Shhatrat/openNAS-case-for-ATX-instruction/stl/hdd-rail.stl

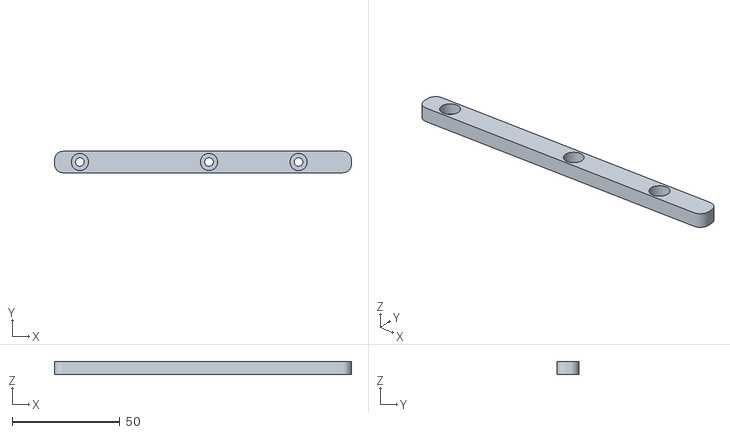
[picture p21: CAD file, 2026-10-17]
stl/hdd-rail.stl
138.0 x 10.0 x 6.00
