Shhatrat/openNAS-case-for-ATX-instruction/stl/foot-left.stl

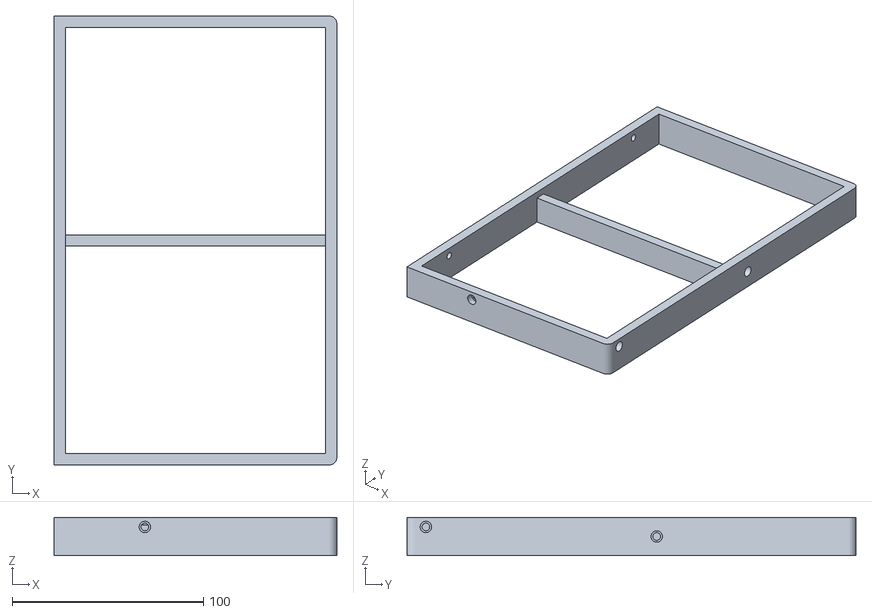
[picture p22: CAD file, 2026-10-17]
stl/foot-left.stl
148.0 x 235.0 x 20.0
