Shhatrat/openNAS-case-for-ATX-instruction/stl/rear-brace-long.stl

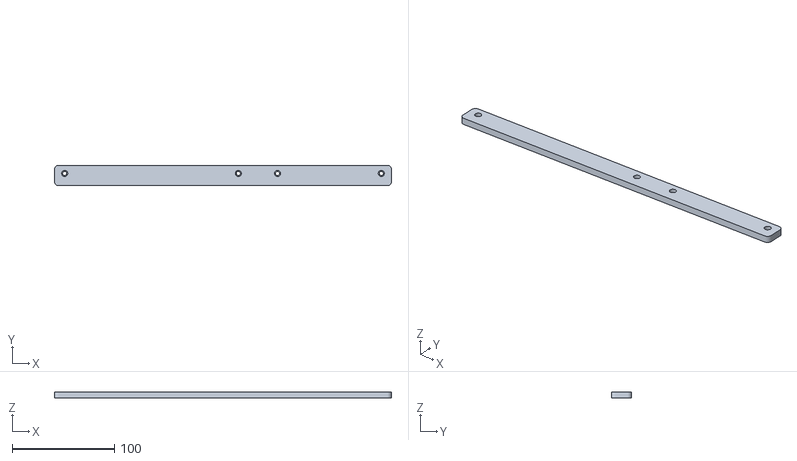
[picture p23: CAD file, 2026-10-17]
stl/rear-brace-long.stl
330.0 x 20.0 x 6.00
