Shhatrat/openNAS-case-for-ATX-instruction/stl/hdd-rack.stl

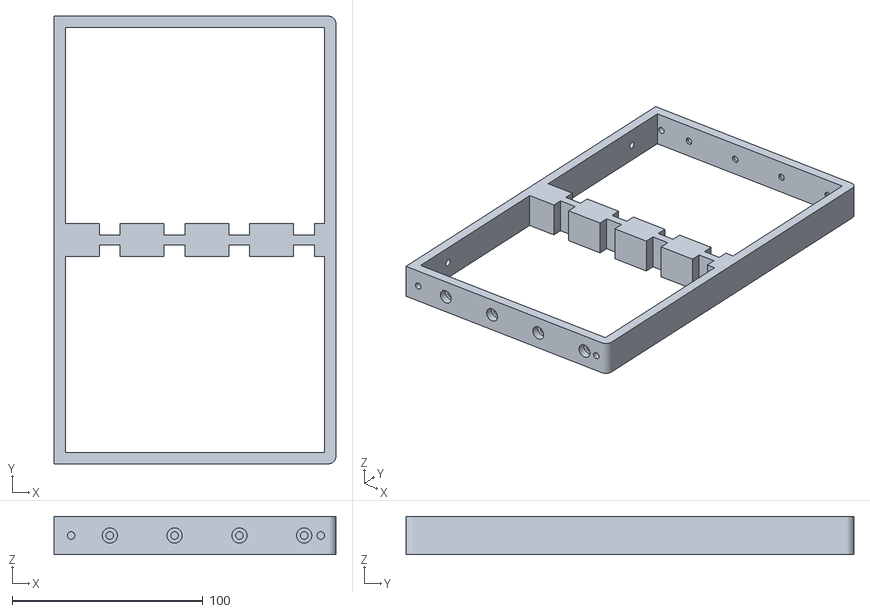
[picture p24: CAD file, 2026-10-17]
stl/hdd-rack.stl
148.0 x 235.0 x 20.0
