Shhatrat/openNAS-case-for-ATX-instruction/stl/front-brace-with-fanmount.stl

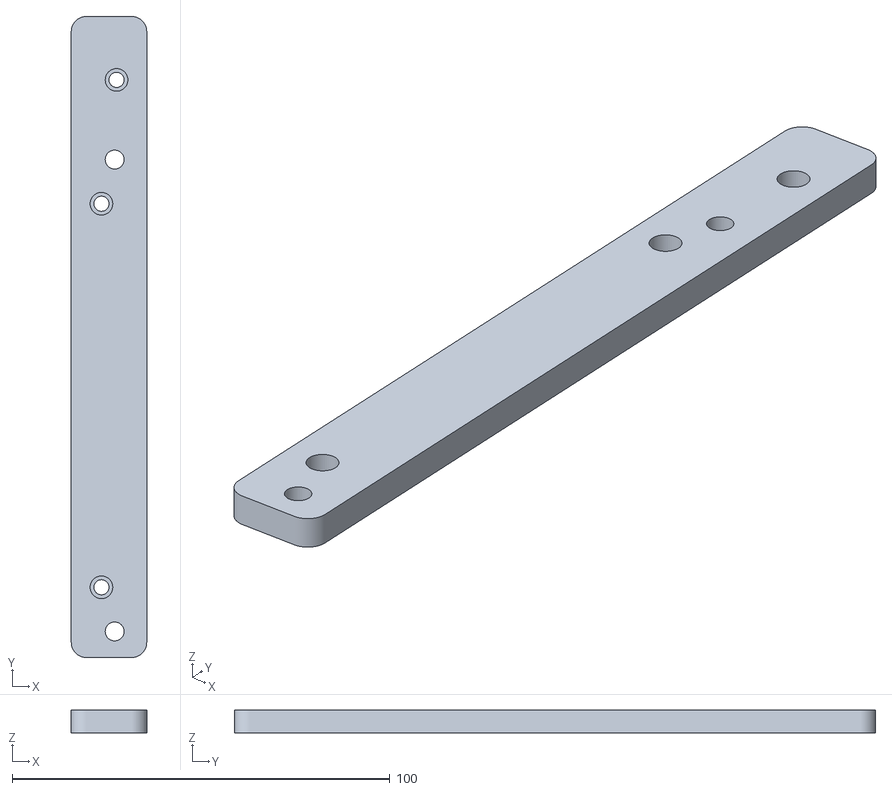
[picture p25: CAD file, 2026-10-17]
stl/front-brace-with-fanmount.stl
20.0 x 169.8 x 6.00
