Shhatrat/openNAS-case-for-ATX-instruction/stl/mb-mount-right.stl

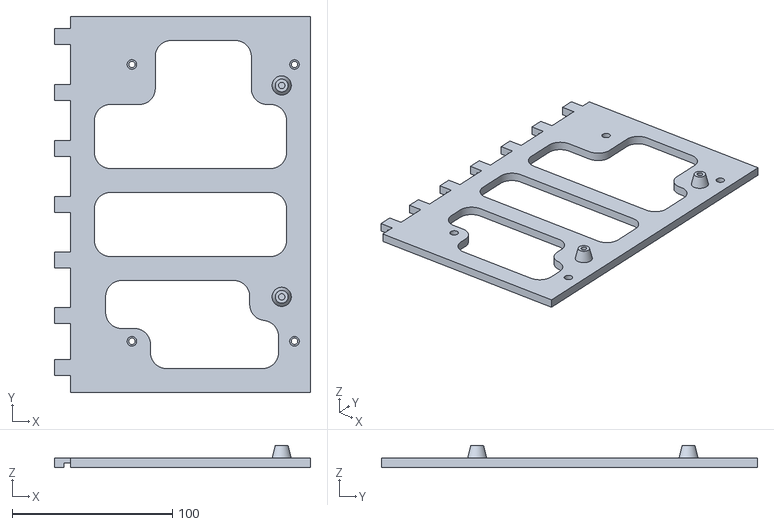
[picture p26: CAD file, 2026-10-17]
stl/mb-mount-right.stl
160.0 x 235.0 x 14.0
