Shhatrat/openNAS-case-for-ATX-instruction/stl/fanmount-bottom.stl

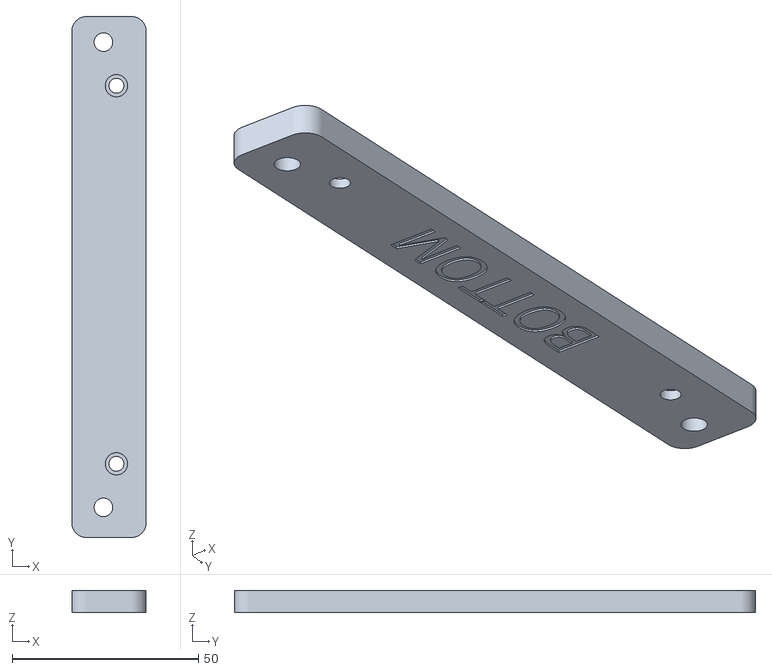
[picture p27: CAD file, 2026-10-17]
stl/fanmount-bottom.stl
20.0 x 140.0 x 6.00
