Shhatrat/openNAS-case-for-ATX-instruction/stl/rear-brace-medium.stl

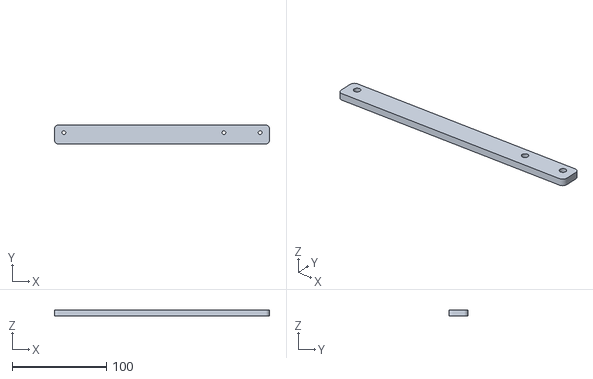
[picture p28: CAD file, 2026-10-17]
stl/rear-brace-medium.stl
228.4 x 20.0 x 6.00
