Shhatrat/openNAS-case-for-ATX-instruction/stl/rear-brace-short.stl

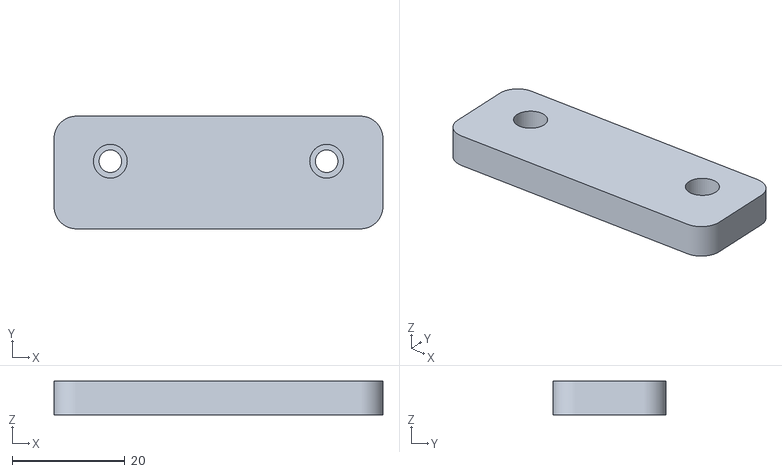
[picture p29: CAD file, 2026-10-17]
stl/rear-brace-short.stl
58.4 x 20.0 x 6.00
