Shhatrat/openNAS-case-for-ATX-instruction/stl/psu-bracket.stl

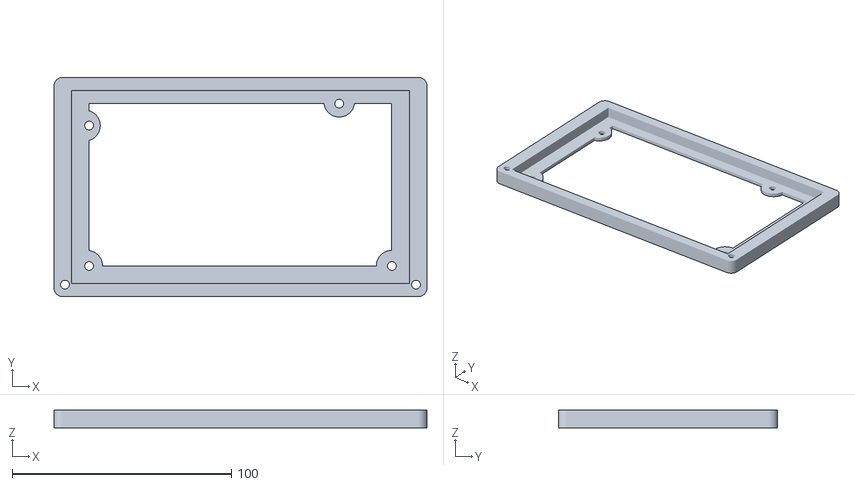
[picture p30: CAD file, 2026-10-17]
stl/psu-bracket.stl
170.0 x 100.0 x 8.00
