Shhatrat/openNAS-case-for-ATX-instruction/stl/rear-brace-long-with-fanmount.stl

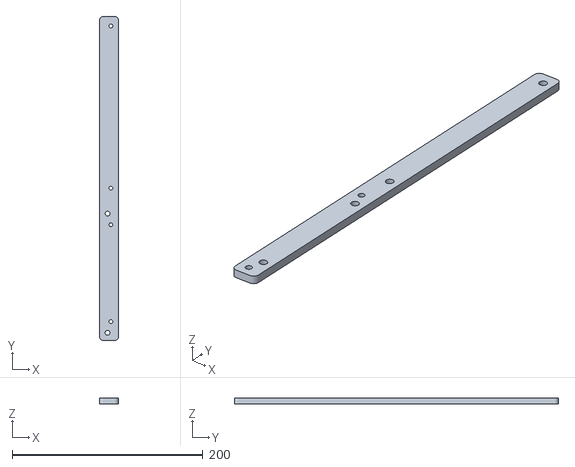
[picture p31: CAD file, 2026-10-17]
stl/rear-brace-long-with-fanmount.stl
20.0 x 339.8 x 6.00
