Shhatrat/openNAS-case-for-ATX-instruction/stl/mb-mount-left.stl

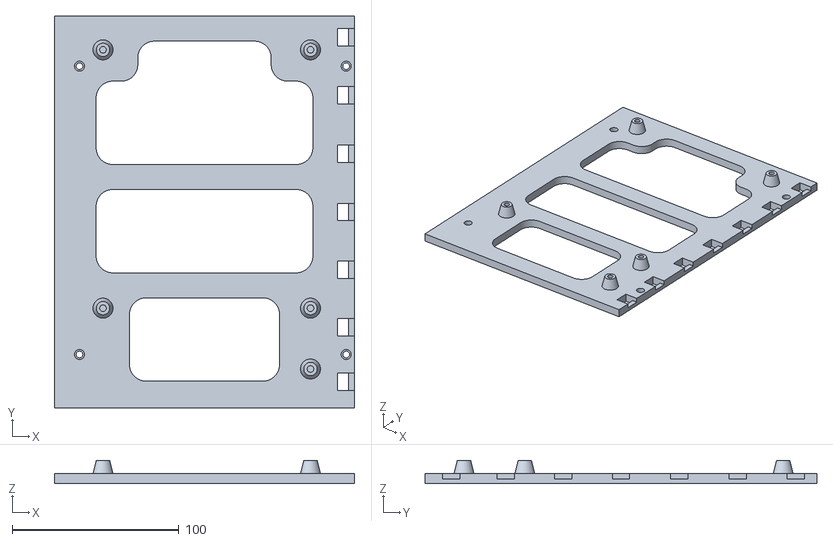
[picture p32: CAD file, 2026-10-17]
stl/mb-mount-left.stl
180.0 x 235.0 x 14.0
