Shhatrat/openNAS-case-for-ATX-instruction/stl/psu-support.stl

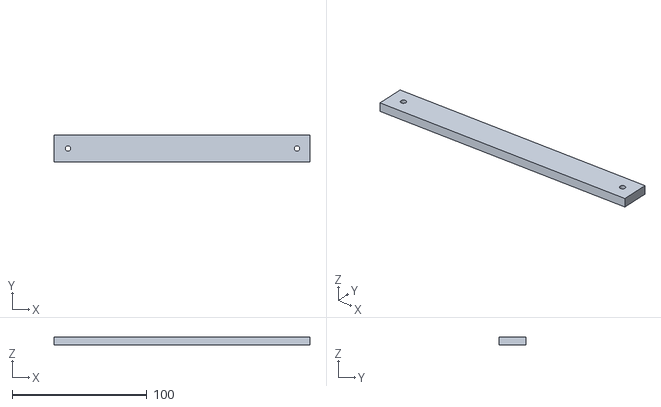
[picture p33: CAD file, 2026-10-17]
stl/psu-support.stl
190.0 x 20.0 x 6.00
