Shhatrat/openNAS-case-for-ATX-instruction/stl/washer.stl

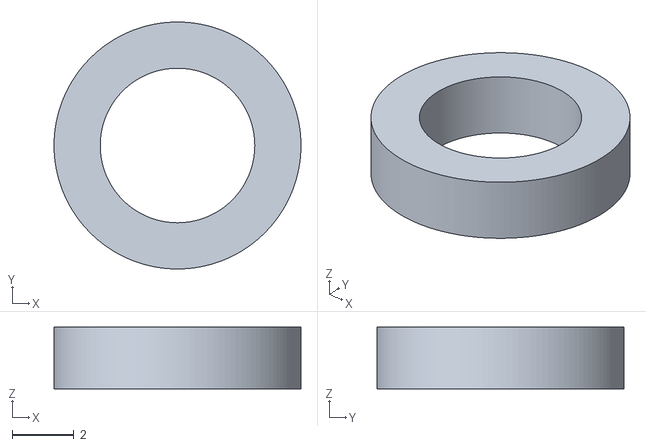
[picture p34: CAD file, 2026-10-17]
stl/washer.stl
8.00 x 8.00 x 2.00
