Shhatrat/openNAS-case-for-ATX-instruction/(list of files, cad)

Other CAD files:
stl/foot-right.stl
stl/fanmount-top.stl
stl/rear-brace-medium-with-fanmount.stl
