Shhatrat/openNAS-case-for-ATX-instruction/instruction.pdf

ASSEMBLY GUIDE

# Open NAS ATX


An open ATX frame for a NAS. The power supply sits on the left, eight 3.5″ drives sit on the right in two

cages, the motherboard lies flat on top, and a 140 mm fan cools the drives from the front.

The frame is about 330 × 235 × 162 mm. It fits ATX, micro-ATX and mini-ITX boards (not E-ATX) and

ATX power supplies.

The author's photo shows the case in a rack cabinet set up like this: PSU, LED and fan at the front.

Heat-set inserts are marked in gold on the models. Melt them in before you start screwing parts together.

Design: Oskari Nykänen · printables.com/model/1437256 (https://www.printables.com/model/1437256-open-nas-case-for-atx) · license CC BY-NC-SA 4.0

Online 3D version: shhatrat.github.io/openNAS-case-for-ATX-instruction

## Printed parts

All files are already oriented for printing and need no supports; you may have to clean up some holes.

Print the frame in ABS (or PLA with good ventilation), and the rails and washers in TPU. Everything

except the longest braces fits a 240×240 mm bed.

FILE | QTY | MATERIAL | PURPOSE
foot-left.stl | 1 | ABS | Left wall of the PSU bay
foot-right.stl | 1 | ABS | Middle wall (with holes for two 3 mm LEDs)
hdd-rack.stl | 2 | ABS | Drive cages. Together the two hold 8 × 3.5″ drives (4

## mb-mount-left.stl + mb-mount-right.stl

| 1+1 | ABS | Motherboard plate, joined with a lap joint
psu-bracket.stl | 1 | ABS | Frame with the ATX hole pattern that the PSU

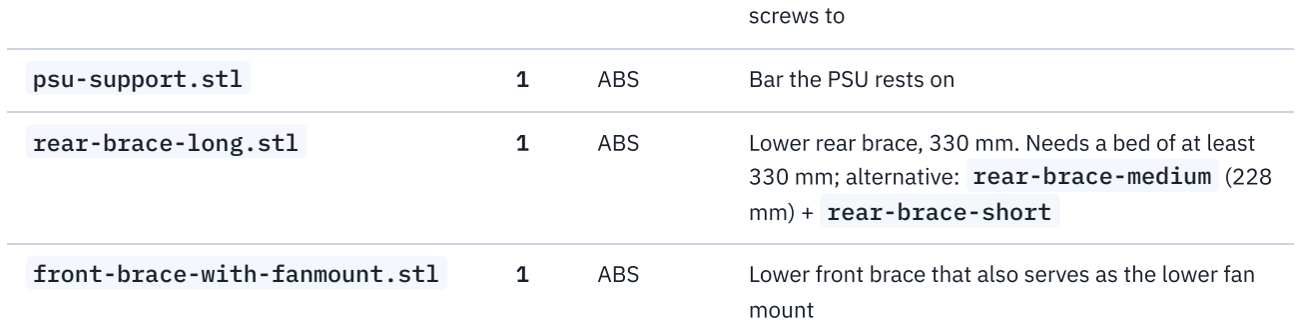
[picture p35: figure]
screws to; psu-support.stl; ABS; Bar the PSU rests on; 330 mm; alternative: rear-brace-medium (228 mm) + rear-brace-short; mount

rear-brace-long.stl | 1 | ABS | Lower rear brace, 330 mm. Needs a bed of at least
front-brace-with-fanmount.stl | 1 | ABS | Lower front brace that also serves as the lower fan
fanmount-top.stl | 1 | ABS | Upper mount for the 140 mm fan

## Variants (optional)

FILE | WHEN TO USE

## rear-brace-long-with-fanmount.stl (340

mm) | Second 140 mm fan at the rear. Replaces

## rear-brace-long ; add a second fanmount-top

rear-brace-medium-with-fanmount.stl | Rear fan without the long brace; connects the middle wall to
| both cages

## rear-brace-medium.stl / rear-brace-short.stl

| Shorter rear braces when 330 mm does not fit your print bed
fanmount-bottom.stl | Lower fan mount on its own, without a brace

## Hardware to buy

ITEM | QTY | WHERE
M3 heat-set inserts (Ø4 hole) | ≈30 | Top edges of the walls and cages, front/rear near the bottom, PSU frame and bar, 7
| | motherboard standoffs

M3 socket head screws, 8–

10 mm

23 | Joining the printed parts
M3 × 6 mm screws | 7 | Motherboard to standoffs

M4 inserts + M4 × ~30 mm

screws

4+4 | Fan (Ø5 holes in the mounts). The author recommends M4, but regular fan screws
| also work
Drive screws 6-32 UNC | 40 | 24 for the rails (3 per drive) and 16 through the cages (2 per drive)
PSU screws 6-32 UNC | 4 | PSU to psu-bracket
140 mm fan | 1–2 | Front of the drive bay (optionally also the rear)
3 mm LED | 2 | Power and HDD, optional
Rubber feet | 8 | Under the walls (instead of printed feet)

## Where this guide comes from

The author (Oskari Nykänen, CC BY-NC-SA 4.0 license) did not publish assembly instructions. I

reconstructed the layout from the geometry of the STL files: hole spacings match between parts to the

millimetre (e.g. plate holes at 31.5/205.5 mm, the ATX PSU pattern 114/138/64.5 mm, the 3.5″ drive

side holes 60/41.6 mm). This also agrees with the author's note that you have to remove the fan to

reach the drive screws, and the fan mount too for the lowest drive. Two things are less certain. The

number of hdd-rack parts (2) follows from the four rows of holes in the plate and in the long brace.

The order of the steps is my suggestion.

# 1of 13 Left wall

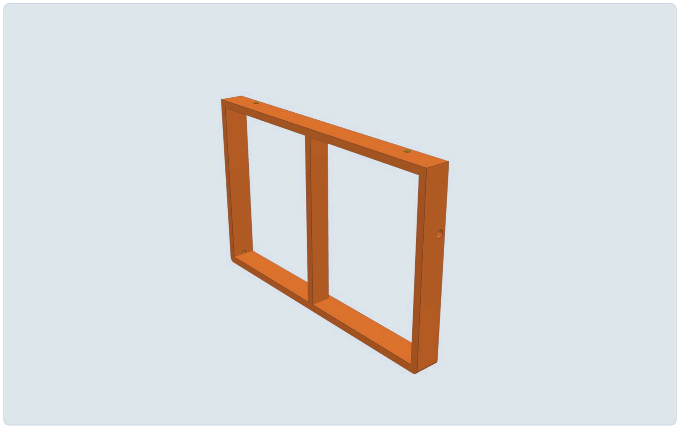
[picture p36: figure]

NEEDED IN THIS STEP

1×

foot-left

3×

M3 insert

Stand foot-left upright, with its long side (235 mm) running front to

back.

The holes without counterbores go on top, because the inserts for the

plate go there. The counterbored holes (Ø6) go at the bottom and the

front, because you drive screws through them.

INSERTS & SCREWS

2 M3 inserts in the top edge

1 M3 insert at the rear near the bottom (for the rear brace)

# 2of 13 PSU supports

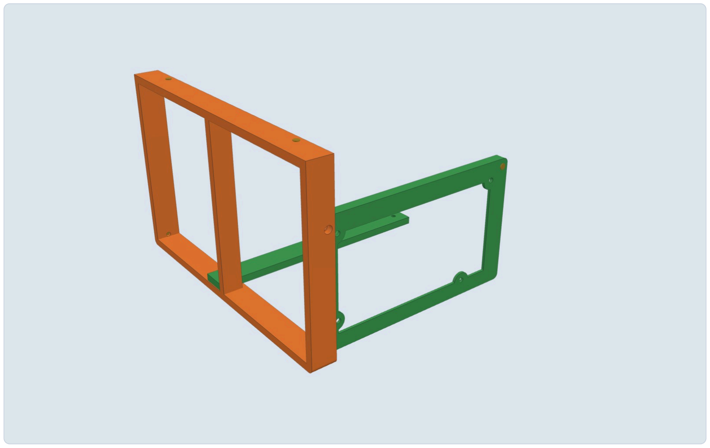
[picture p37: figure]
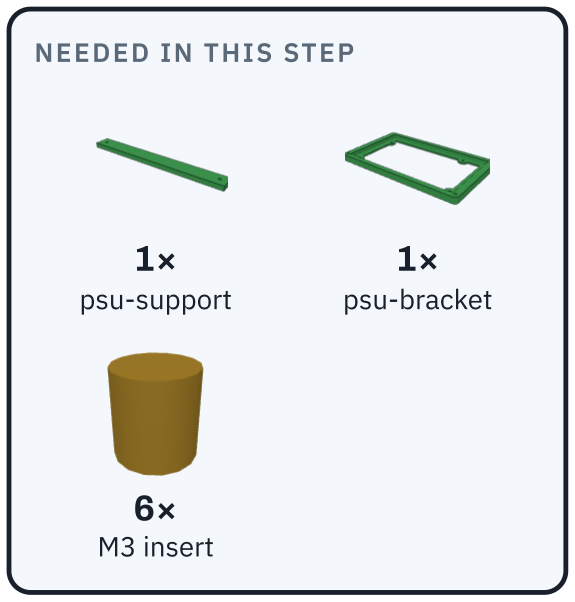
[picture p38: figure]
NEEDED IN THIS STEP; psu-support; psu-bracket; M3 insert

psu-support lies on the lower bar of the walls, about 12 cm from the

front. The power supply rests on it.

psu-bracket stands just behind the front bar of the wall. It has the

ATX hole pattern (114 / 138 / 64.5 mm).

Slide the ends of both parts into the window of the left wall.

INSERTS & SCREWS

2 M3 inserts in psu-support (from below)

4 M3 inserts in psu-bracket: 2 at the front and 2 in the bottom edge

# 3of 13 Middle wall

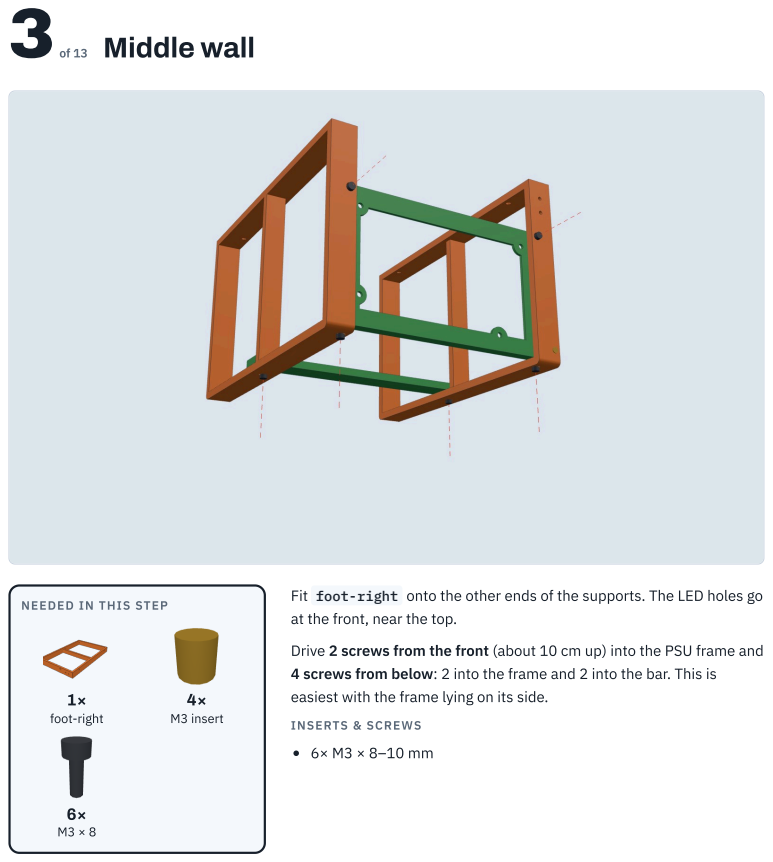
[picture p39: page 6]
foot-right; M3 insert; INSERTS & SCREWS

Fit foot-right onto the other ends of the supports. The LED holes go

NEEDED IN THIS STEP

at the front, near the top.

Drive 2 screws from the front (about 10 cm up) into the PSU frame and

4 screws from below: 2 into the frame and 2 into the bar. This is

easiest with the frame lying on its side.

# 4of 13 Power supply

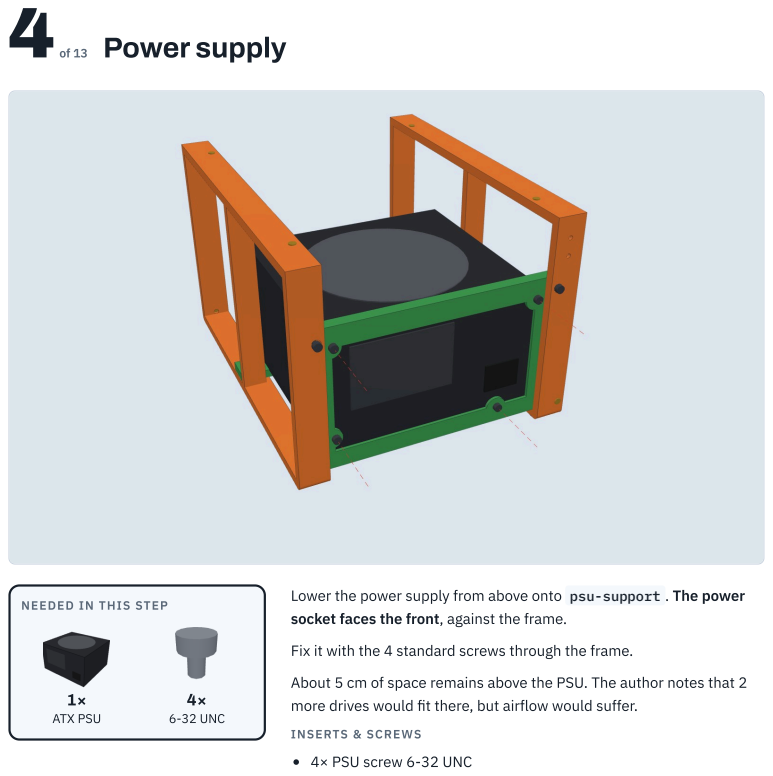
[picture p40: page 7]
ATX PSU; 6-32 UNC; INSERTS & SCREWS

Lower the power supply from above onto psu-support . The power
socket faces the front, against the frame.

NEEDED IN THIS STEP

Fix it with the 4 standard screws through the frame.

About 5 cm of space remains above the PSU. The author notes that 2

more drives would fit there, but airflow would suffer.

4× PSU screw 6-32 UNC

# 5of 13 Drive cages


NEEDED IN THIS STEP

2×

hdd-rack

12×

M3 insert

Print two hdd-rack parts and stand them parallel to the walls: the

first 18 mm from the middle wall, the second 81 mm further, at the

right edge.

They stand loose for now. The plate in the next step sets their exact

spacing.

The notches in the middle bar are slots for the TPU rails.

INSERTS & SCREWS

6 M3 inserts per cage: 2 on top, 2 at the front and 2 at the rear

# 6of 13 Motherboard plate

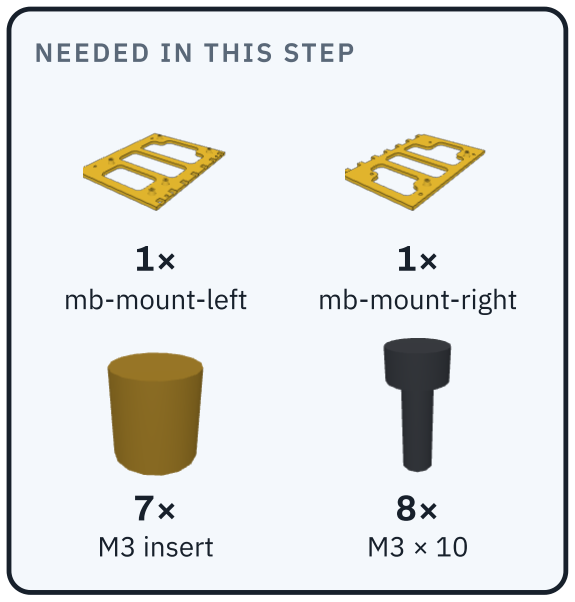
[picture p41: figure]
NEEDED IN THIS STEP; mb-mount-left; mb-mount-right; M3 insert

Join the two halves with the lap joint: the teeth of the right half fit into

the slots of the left one. No glue is needed, because the screws hold

everything together.

Melt inserts into the 7 standoffs. Then screw the plate with 8 screws

(the heads sit in counterbores) to the top edges of all four walls.

INSERTS & SCREWS

8× M3 × 8–10 mm

Optional: the joint has a Ø3.3 mm channel for a pin (e.g. a piece of

2.85 mm filament)

# 7of 13 Drives with rails

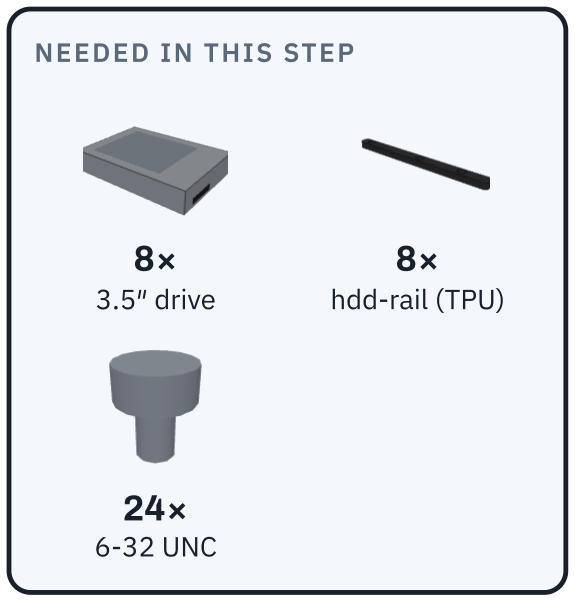
[picture p42: figure]
NEEDED IN THIS STEP; 3.5″ drive; hdd-rail (TPU); 6-32 UNC

Screw an hdd-rail to each drive with three screws into the side

holes (spacing 60 / 41.6 mm). The rail goes on the side that faces the

middle of the case: the rear side of the front drives and the front side of

the rear drives.

Slide the drives in from the right through the windows of both cages,

SATA connectors facing out, until they touch the middle wall. The rail

slides into the notch in the middle bar.

INSERTS & SCREWS

24× 6-32 UNC screw (3 per drive)

# 8of 13 Screw in the drives

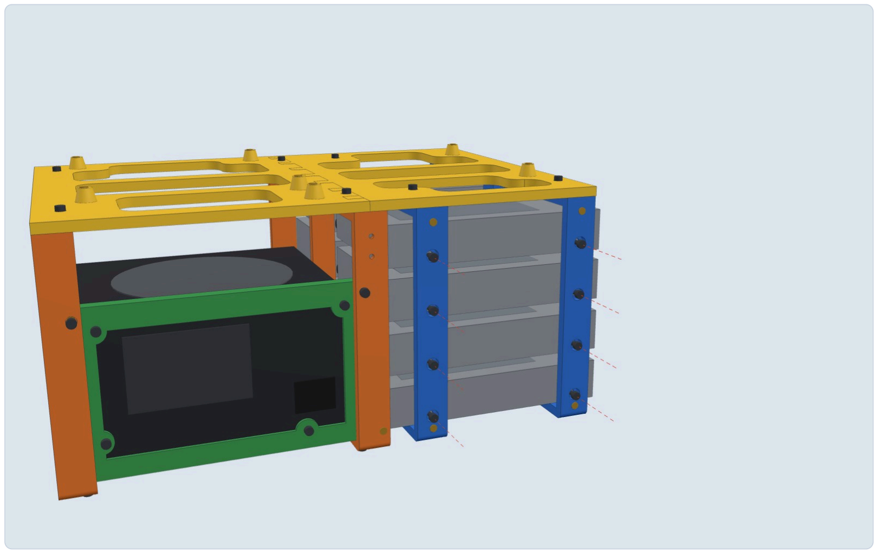
[picture p43: figure]

NEEDED IN THIS STEP

16×

6-32 UNC

Each drive gets 2 screws through the outer bar of both cages: front

drives from the front, rear drives from the rear. The heads sit in the Ø8

counterbores.

Do this before fitting the braces and the fan. They cover the

screws of the lowest drive afterwards.

INSERTS & SCREWS

16× 6-32 UNC screw

# 9of 13 Rear brace

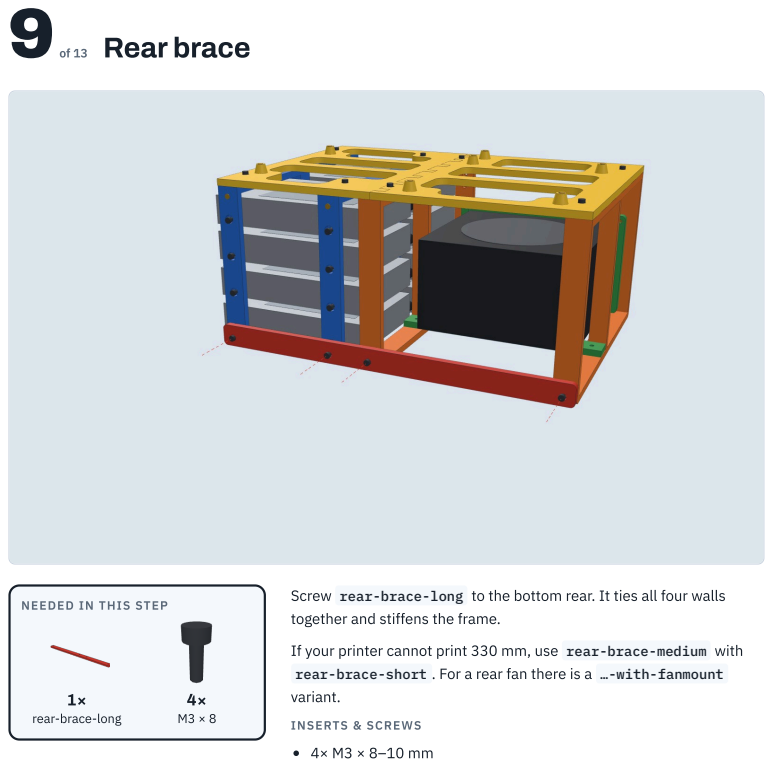
[picture p44: page 12]
variant.; INSERTS & SCREWS

Screw rear-brace-long to the bottom rear. It ties all four walls

NEEDED IN THIS STEP

together and stiffens the frame.

If your printer cannot print 330 mm, use rear-brace-medium with
rear-brace-short . For a rear fan there is a …-with-fanmount

rear-brace-long

# 10of 13 Fan mounts

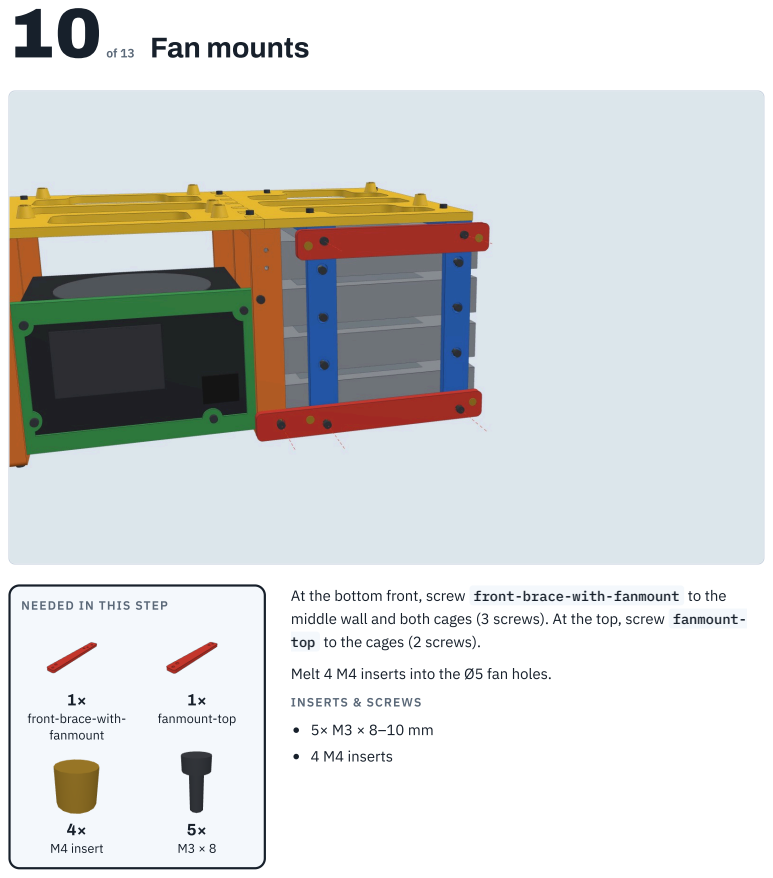
[picture p45: page 13]
fanmount-top; M4 insert; INSERTS & SCREWS; 4 M4 inserts

At the bottom front, screw front-brace-with-fanmount to the

NEEDED IN THIS STEP

middle wall and both cages (3 screws). At the top, screw fanmount-

top to the cages (2 screws).

Melt 4 M4 inserts into the Ø5 fan holes.

front-brace-with-
fanmount

## 11of 13 140 mm fan

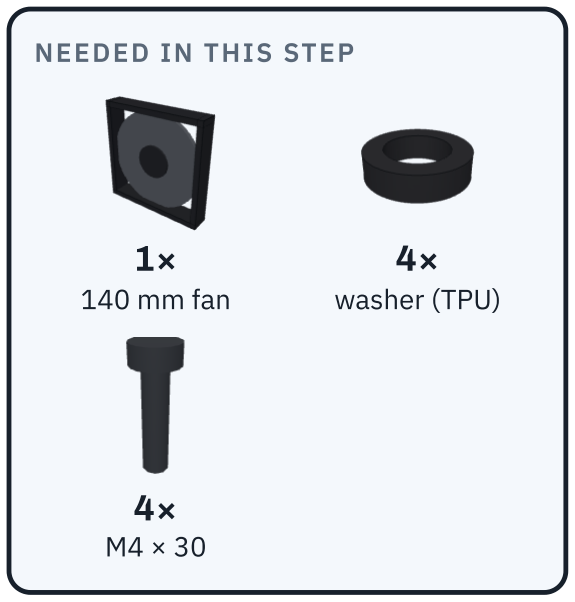
[picture p46: figure]
NEEDED IN THIS STEP; 140 mm fan; washer (TPU)

Put the TPU washers between the fan and the mounts to damp

vibration. Fix the fan with 4 M4 screws.

Ideally it should blow in: the air then flows through the 8 mm gaps

between the drives to the rear of the case.

INSERTS & SCREWS

4× M4 × 30 mm (or the screws supplied with the fan)

# 12of 13 Motherboard


NEEDED IN THIS STEP

1×

ATX motherboard

7×

M3 × 6

Place the motherboard on the 7 standoffs (ATX pattern) and screw it to

the inserts with M3 screws. Micro-ATX and mini-ITX boards use some

of the same holes.

Finally route the cables: 24-pin and CPU power from the PSU below,

SATA on the right side of the drives.

INSERTS & SCREWS

7× M3 × 6 mm

# 13of 13 LEDs and feet

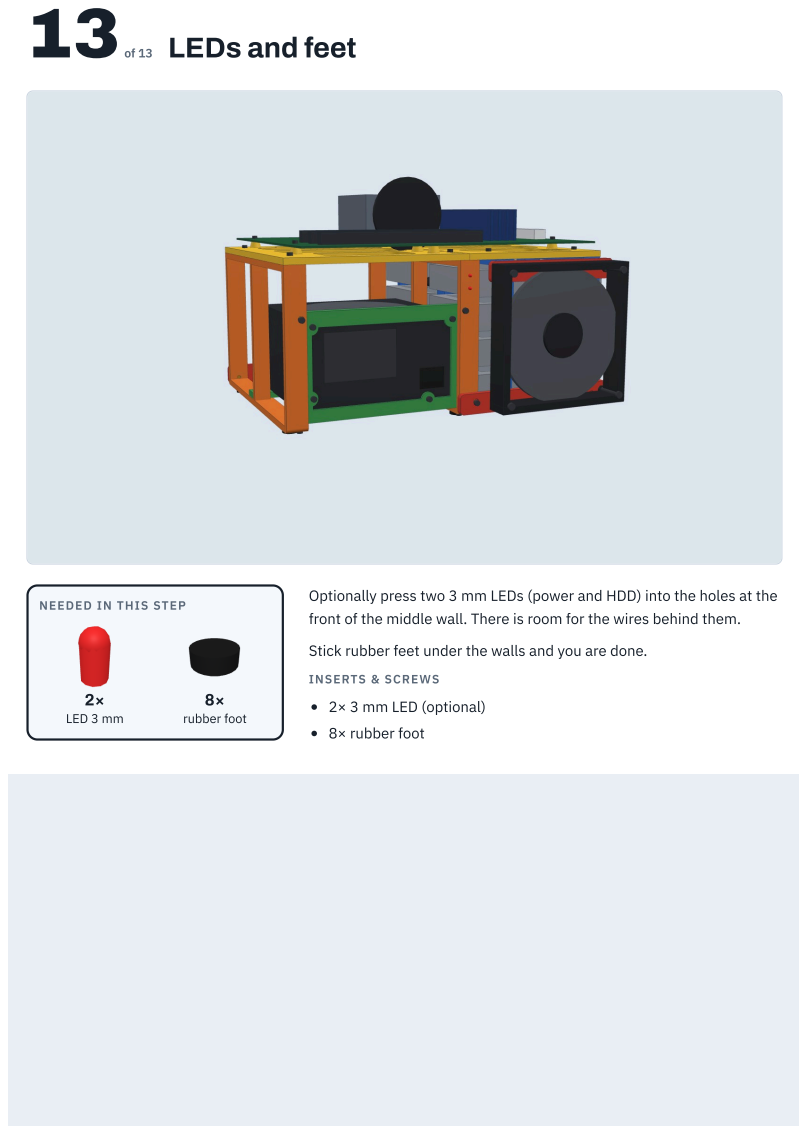
[picture p47: page 16]
LED 3 mm; rubber foot; INSERTS & SCREWS; 8× rubber foot

Optionally press two 3 mm LEDs (power and HDD) into the holes at the

NEEDED IN THIS STEP

front of the middle wall. There is room for the wires behind them.

Stick rubber feet under the walls and you are done.

2× 3 mm LED (optional)
